LordOlumide/arduino_pid_controlled_dc_motor/Untitled design.png

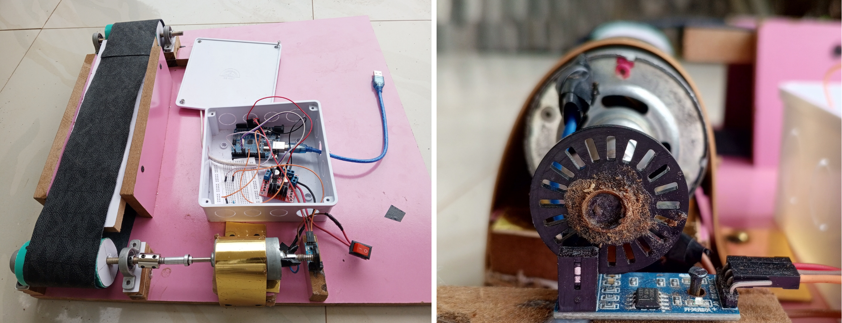
Untitled design.png
