LordOlumide/arduino_pid_controlled_dc_motor/Data/filtered and unfiltered response.png

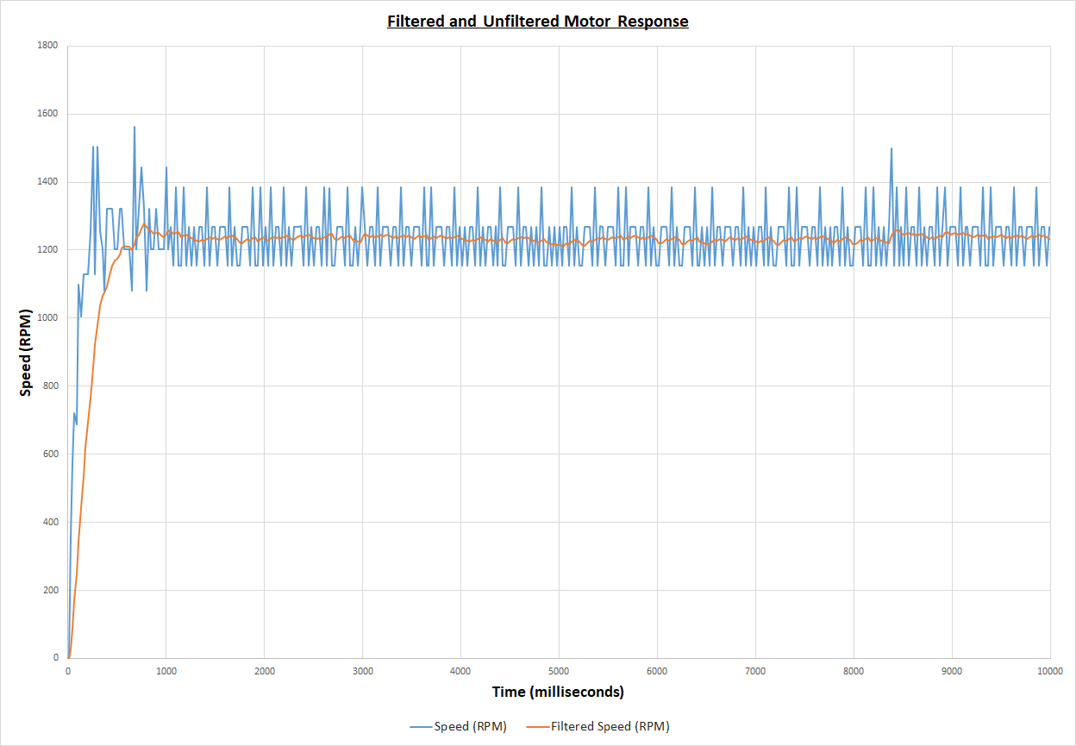
Data/filtered and unfiltered response.png
