LordOlumide/arduino_pid_controlled_dc_motor/Data/load response 2.png

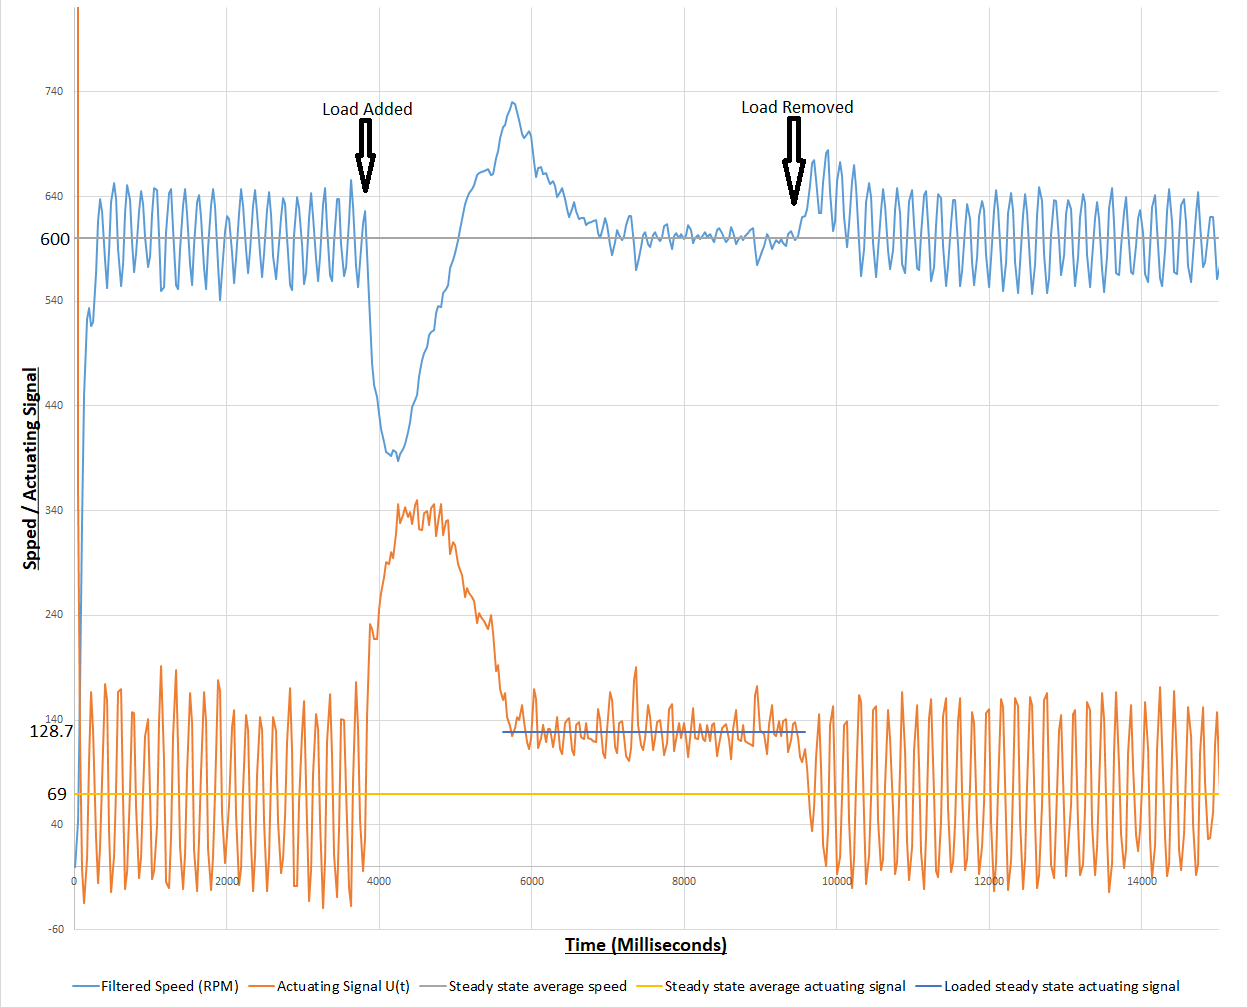
Data/load response 2.png
