LordOlumide/arduino_pid_controlled_dc_motor/Data/Open loop motor response.png

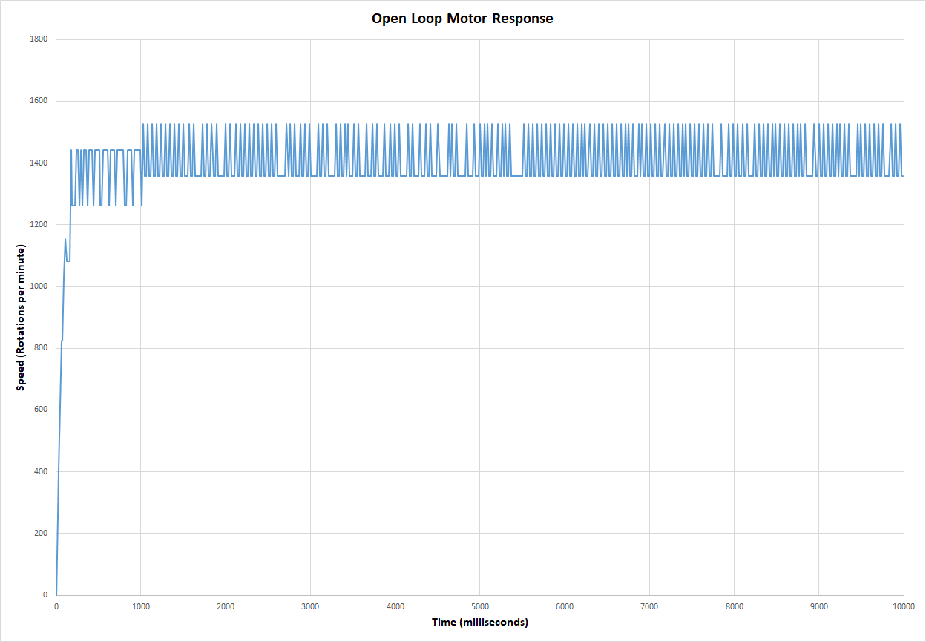
Data/Open loop motor response.png
