LordOlumide/arduino_pid_controlled_dc_motor/Data/p control.png

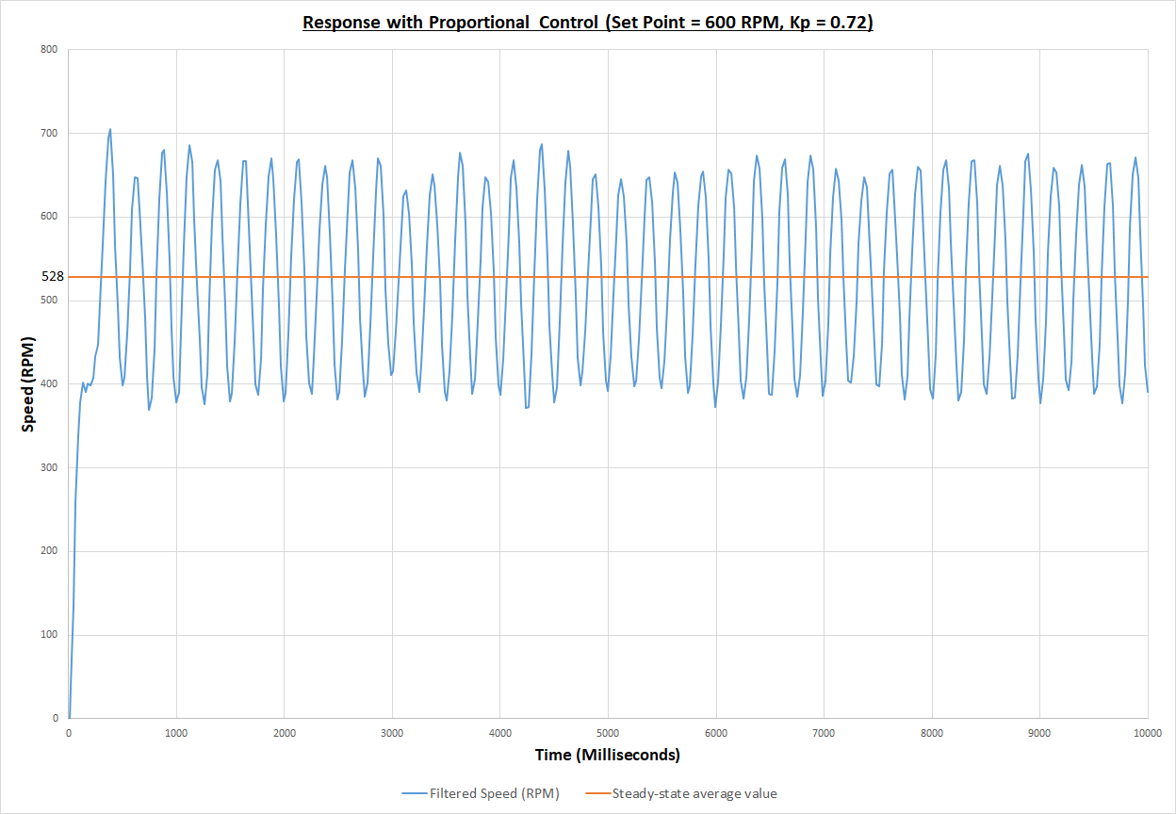
Data/p control.png
