LordOlumide/arduino_pid_controlled_dc_motor/Data/perforamance comparism.JPG

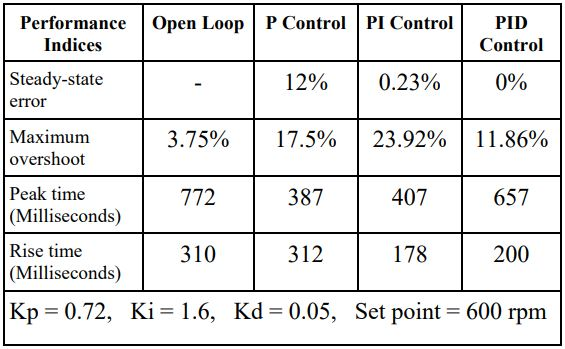
Data/perforamance comparism.JPG
