LordOlumide/arduino_pid_controlled_dc_motor/Data/PI control.png

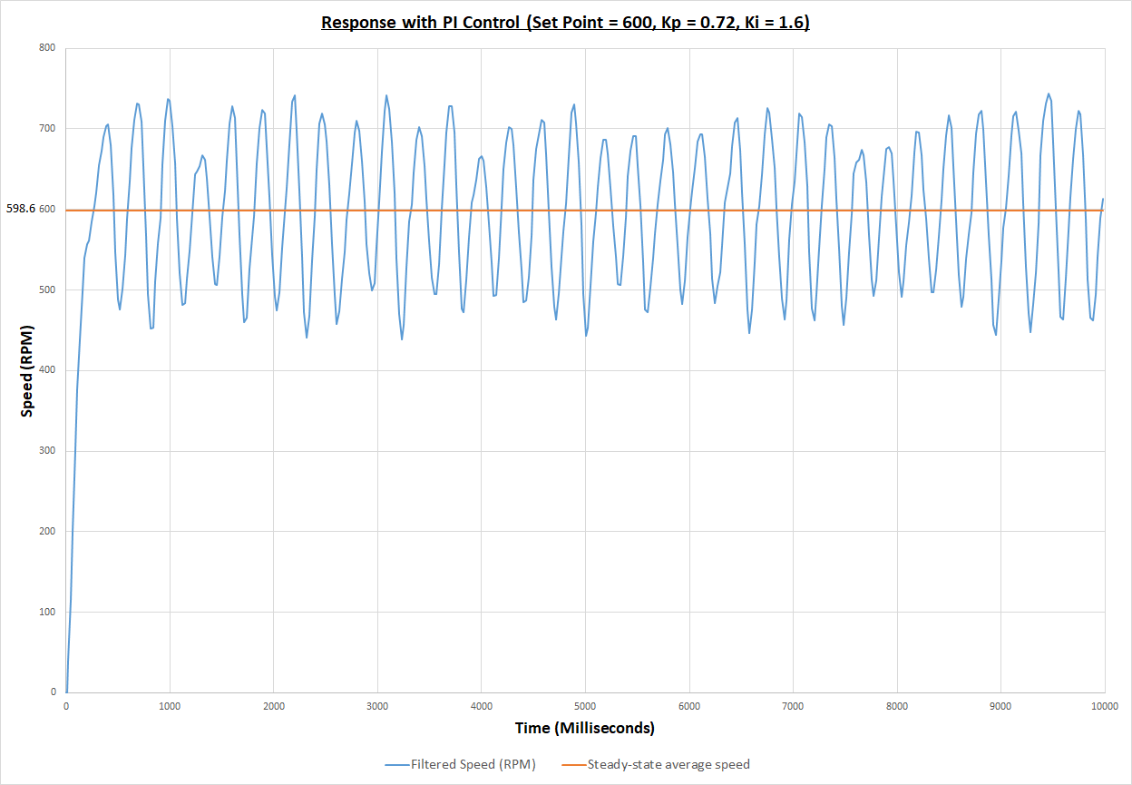
Data/PI control.png
