LordOlumide/arduino_pid_controlled_dc_motor/Data/PID control 2.png

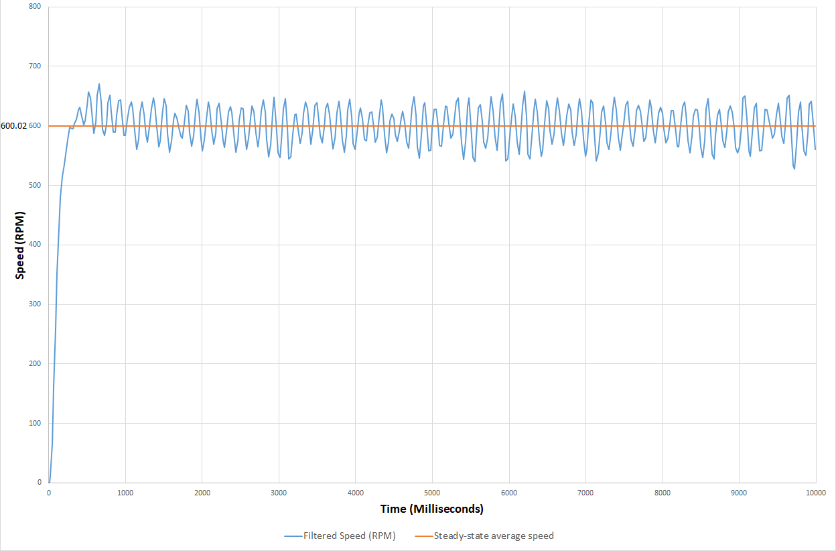
Data/PID control 2.png
