LordOlumide/arduino_pid_controlled_dc_motor/Data/visualization in excel.JPG

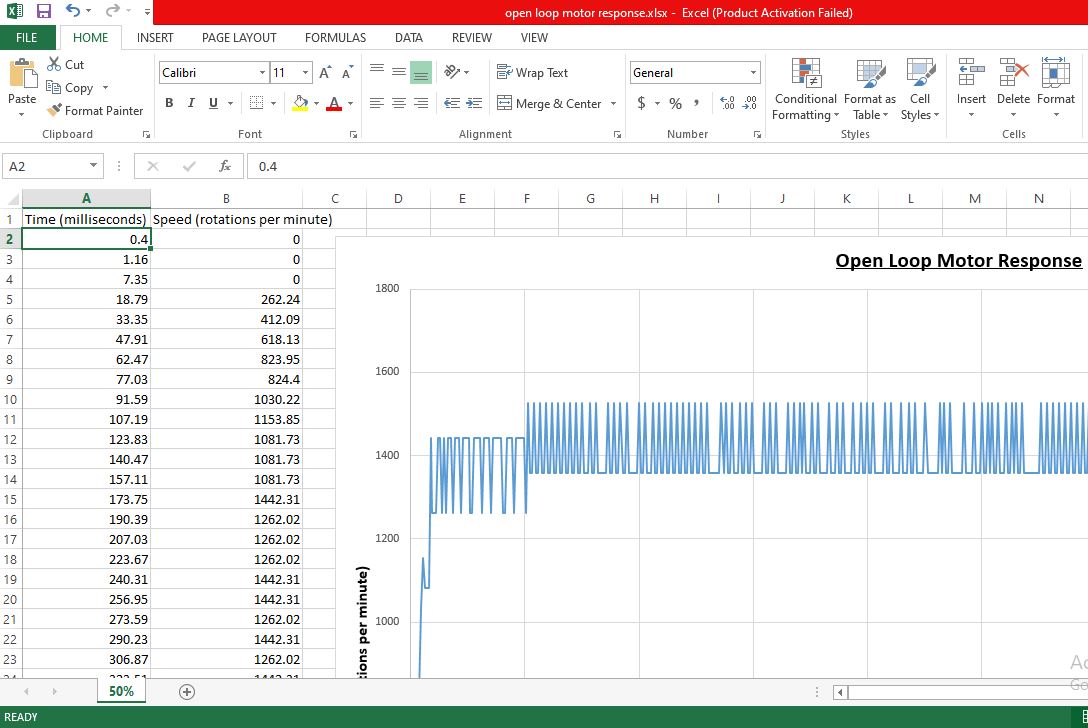
Data/visualization in excel.JPG
