LordOlumide/arduino_pid_controlled_dc_motor/(commit log)

2024-10-19 first commit 2
    [PI control.csv, PI control.xlsx, PID control 2.csv, PID control 2.xlsx, filtered speed response.xlsx, load response.xlsx, open loop motor response.xlsx, proprtional control at 0.72 second.csv]
2025-01-21 Completed, I think
    [PI control 2.xlsx, PI control.csv, PID control 2.csv, PID control 3.xlsx, load response 2.xlsx, load response 3.xlsx, load response.xlsx, p control 2.xlsx]
